sinanuyan/WeatherStation/README.md

# WeatherStation
Opensource Weather Station with OpenWeather
