sinanuyan/WeatherStation/hardware/PCB/TemperatureSensor.kicad_pcb

## KiCad design hardware/PCB/TemperatureSensor.kicad_pcb (2021-02-13)

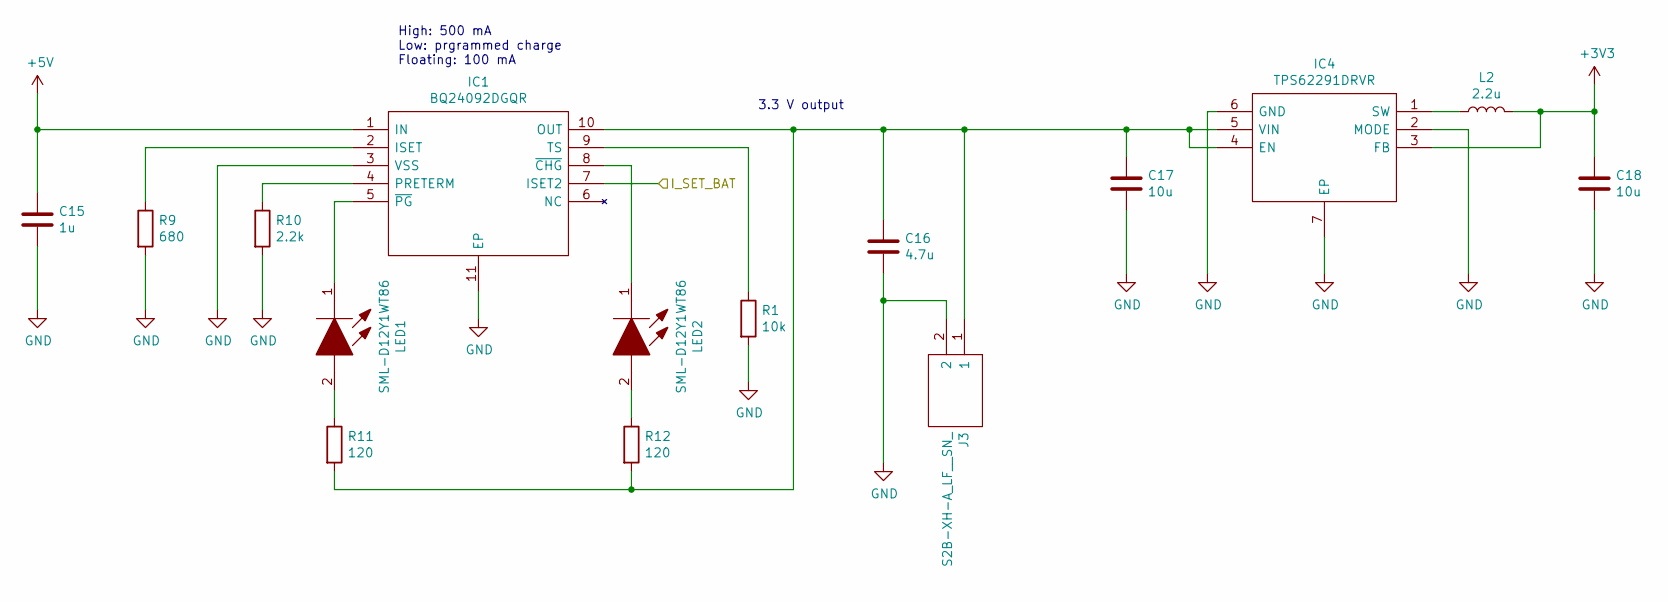
[picture p1: schematic PowerSupply.sch]

Parts:
C15: 1u; C_0603_1608Metric
C16: 4.7u; C_0603_1608Metric
C17, C18: 10u; C_0603_1608Metric
IC1: BQ24092DGQR; SOP50P490X110-11N; Mouser Part Number 595-BQ24092DGQR
IC4: TPS62291DRVR; SON65P200X200X80-7N; Mouser Part Number 595-TPS62291DRVR
J3: S2B-XH-A_LF__SN_; SHDRRA2W80P0X250_1X2_740X1150X610P; Manufacturer_Part_Number S2B-XH-A(LF)(SN)
L2: 2.2u; L_Coilcraft_LPS4018; Mouser Part Number 994-LPS4018-222MRB
LED1, LED2: SML-D12Y1WT86; LEDC1608X55N; Mouser Part Number 755-SML-D12Y1WT86
R1: 10k; R_0603_1608Metric
R9: 680; R_0603_1608Metric
R10: 2.2k; R_0603_1608Metric
R11, R12: 120; R_0603_1608Metric

Connections:
+5V: C15.1, IC1.1 (IN); also elsewhere on the board
/ESP32/BAT_PWR: IC1.7 (ISET2); also elsewhere on the board
GND: C15.2, C16.2, C17.2, C18.2, IC1.3 (VSS), IC1.11 (EP), IC4.2 (MODE), IC4.6 (GND), IC4.7 (EP), J3.2, R1.2, R9.2, R10.2; also elsewhere on the board
unnamed: C16.1, C17.1, IC1.10 (OUT), IC4.4 (EN), IC4.5 (VIN), J3.1, R11.2, R12.2
unnamed: IC1.2 (ISET), R9.1
unnamed: IC1.4 (PRETERM), R10.1
unnamed: IC1.5 (~PG), LED1.1
unnamed: IC1.8 (~CHG), LED2.1
unnamed: IC1.9 (TS), R1.1
unnamed: IC4.1 (SW), L2.1
unnamed: LED1.2, R11.1
unnamed: LED2.2, R12.1

Notes on the sheet:
3.3 V output
High: 500 mA Low: prgrammed charge Floating: 100 mA

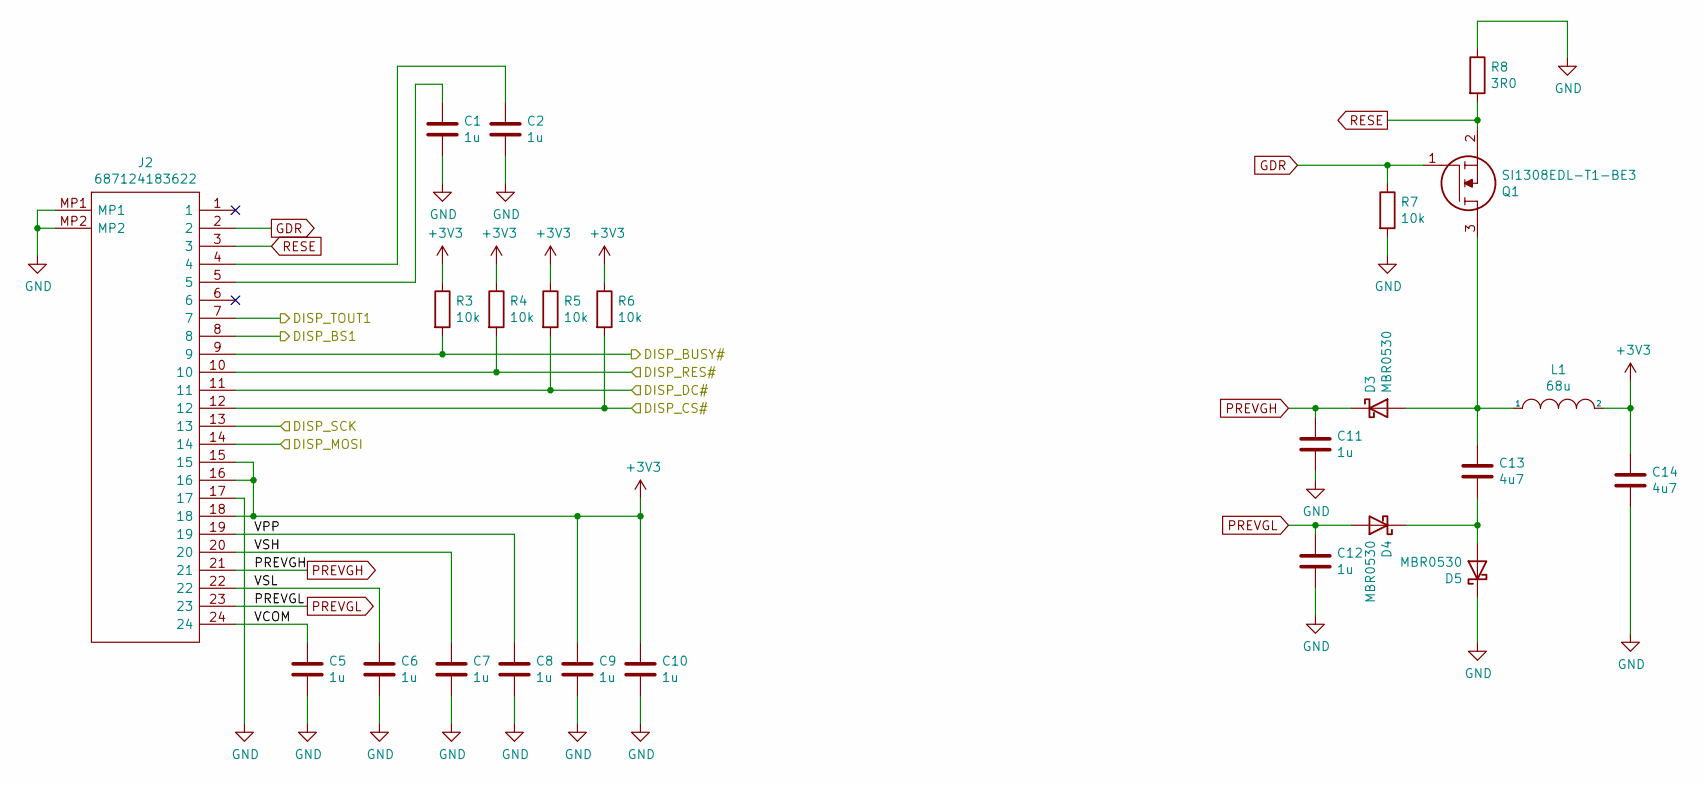
[picture p2: schematic Display.sch]

Parts:
C1, C2, C5, C6, C7, C8, C9, C10, C11, C12: 1u; C_0603_1608Metric
C13, C14: 4u7; C_0603_1608Metric
D3, D4, D5: MBR0530; D_SOD-123
J2: 687124183622; Mouser Part Number 710-687124183622
L1: 68u; L_0805_2012Metric
Q1: SI1308EDL-T1-BE3; SOT65P210X110-3N; Manufacturer_Part_Number SI1308EDL-T1-BE3
R3, R4, R5, R6, R7: 10k; R_0603_1608Metric
R8: 3R0; R_0603_1608Metric

Connections:
/Display/DISP_BS1: J2.8; also elsewhere on the board
/Display/DISP_MOSI: J2.14; also elsewhere on the board
/Display/DISP_TOUT1: J2.7; also elsewhere on the board
/Display/VCOM: C5.1, J2.24
/Display/VPP: C8.1, J2.19
/Display/VSH: C7.1, J2.20
/Display/VSL: C6.1, J2.22
/ESP32/DISP_BUSY: J2.9, R3.2; also elsewhere on the board
/ESP32/DISP_CLK: J2.13; also elsewhere on the board
/ESP32/DISP_CS: J2.12, R6.2; also elsewhere on the board
/ESP32/DISP_DC: J2.11, R5.2; also elsewhere on the board
/ESP32/DISP_RES: J2.10, R4.2; also elsewhere on the board
GDR: J2.2, Q1.1, R7.1
GND: C1.2, C2.2, C5.2, C6.2, C7.2, C8.2, C9.2, C10.2, C11.2, C12.2, C14.2, D5.1 (K), J2.17, J2.MP1, J2.MP2, R7.2, R8.1; also elsewhere on the board
unnamed: C1.1, J2.5
unnamed: C2.1, J2.4
unnamed: C13.1, D3.2 (A), L1.1, Q1.3
unnamed: C13.2, D4.1 (K), D5.2 (A)
PREVGH: C11.1, D3.1 (K), J2.21
PREVGL: C12.1, D4.2 (A), J2.23
RESE: J2.3, Q1.2, R8.2

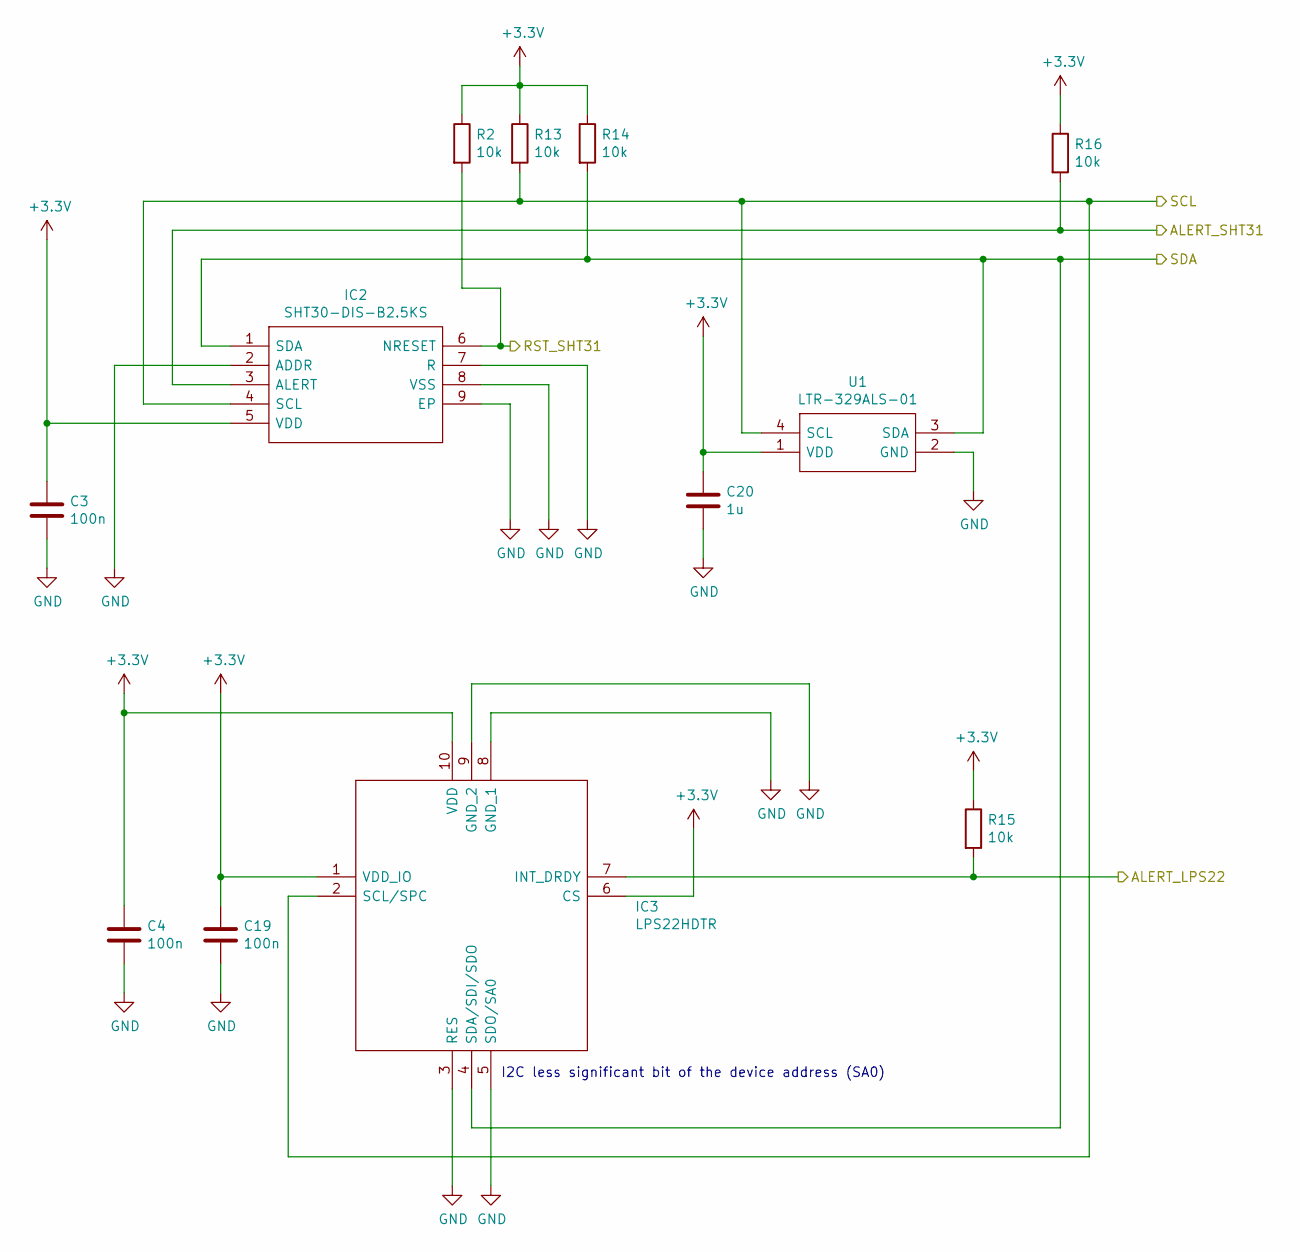
[picture p3: schematic Sensor.sch]

Parts:
C3, C4, C19: 100n; C_0603_1608Metric
C20: 1u; C_0603_1608Metric
IC2: SHT30-DIS-B2.5KS; SHT30DISB25KS; Manufacturer_Part_Number SHT30-DIS-B2.5KS
IC3: LPS22HDTR; Mouser Part Number 511-LPS22HDTR
R2, R13, R14, R15, R16: 10k; R_0603_1608Metric
U1: LTR-329ALS-01; LTR329ALS01; Mouser Part Number 859-LTR-329ALS-01

Connections:
/ESP32/I2C_SCL: IC2.4 (SCL), IC3.2 (SCL/SPC), R13.2, U1.4 (SCL); also elsewhere on the board
/ESP32/I2C_SDA: IC2.1 (SDA), IC3.4 (SDA/SDI/SDO), R14.2, U1.3 (SDA); also elsewhere on the board
/Sensor/ALERT_LPS22: IC3.7 (INT_DRDY), R15.2
/Sensor/ALERT_SHT31: IC2.3 (ALERT), R16.2
/Sensor/RST_SHT31: IC2.6 (NRESET), R2.2; also elsewhere on the board
GND: C3.2, C4.2, C19.2, C20.2, IC2.2 (ADDR), IC2.7 (R), IC2.8 (VSS), IC2.9 (EP), IC3.3 (RES), IC3.5 (SDO/SA0), IC3.8 (GND_1), IC3.9 (GND_2), U1.2 (GND); also elsewhere on the board

Notes on the sheet:
I2C less significant bit of the device address (SA0)

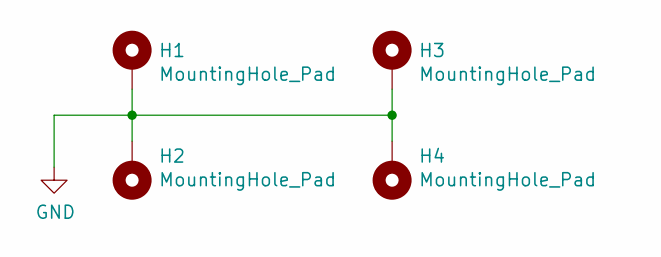
[picture p4: schematic MECH.sch]

Parts:
H1, H2, H3, H4: MountingHole_Pad; MountingHole_2.5mm

Connections:
GND: H1.1, H2.1, H3.1, H4.1; also elsewhere on the board

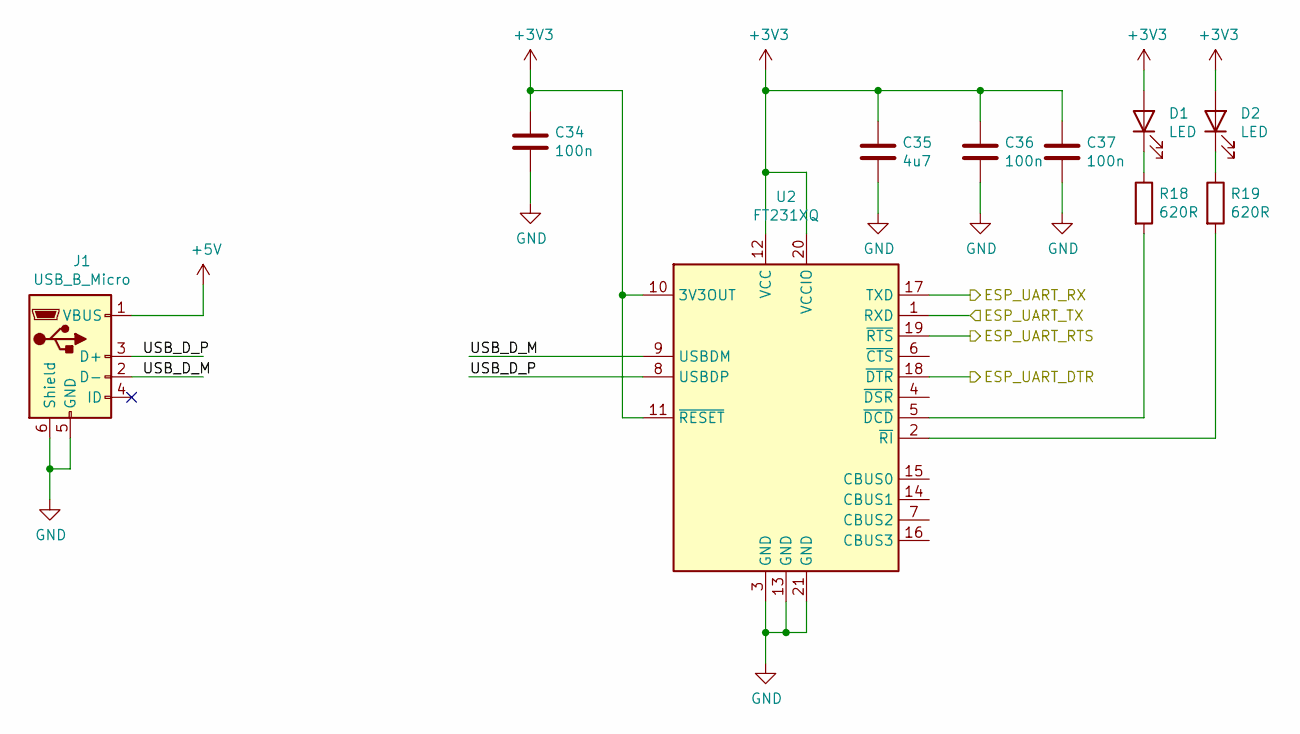
[picture p5: schematic USB_FTDI.sch]

Parts:
C34, C36, C37: 100n; C_0603_1608Metric
C35: 4u7; C_0603_1608Metric
D1, D2: LED; LED_0603_1608Metric
J1: USB_B_Micro; USB_Micro-B_Amphenol_10118194_Horizontal
R18, R19: 620R; R_0603_1608Metric
U2: FT231XQ; QFN-20-1EP_4x4mm_P0.5mm_EP2.5x2.5mm

Connections:
+5V: J1.1 (VBUS); also elsewhere on the board
/USB FTDI/ESP_UART_DTR: U2.18 (~DTR); also elsewhere on the board
/USB FTDI/ESP_UART_RTS: U2.19 (~RTS); also elsewhere on the board
/USB FTDI/ESP_UART_RX: U2.17 (TXD); also elsewhere on the board
/USB FTDI/ESP_UART_TX: U2.1 (RXD); also elsewhere on the board
/USB FTDI/USB_D_M: J1.2 (D-), U2.9 (USBDM)
/USB FTDI/USB_D_P: J1.3 (D+), U2.8 (USBDP)
GND: C34.2, C35.2, C36.2, C37.2, J1.5 (GND), J1.6 (Shield), U2.3 (GND), U2.13 (GND), U2.21 (GND); also elsewhere on the board
unnamed: D1.1 (K), R18.1
unnamed: D2.1 (K), R19.1
unnamed: R18.2, U2.5 (~DCD)
unnamed: R19.2, U2.2 (~RI)

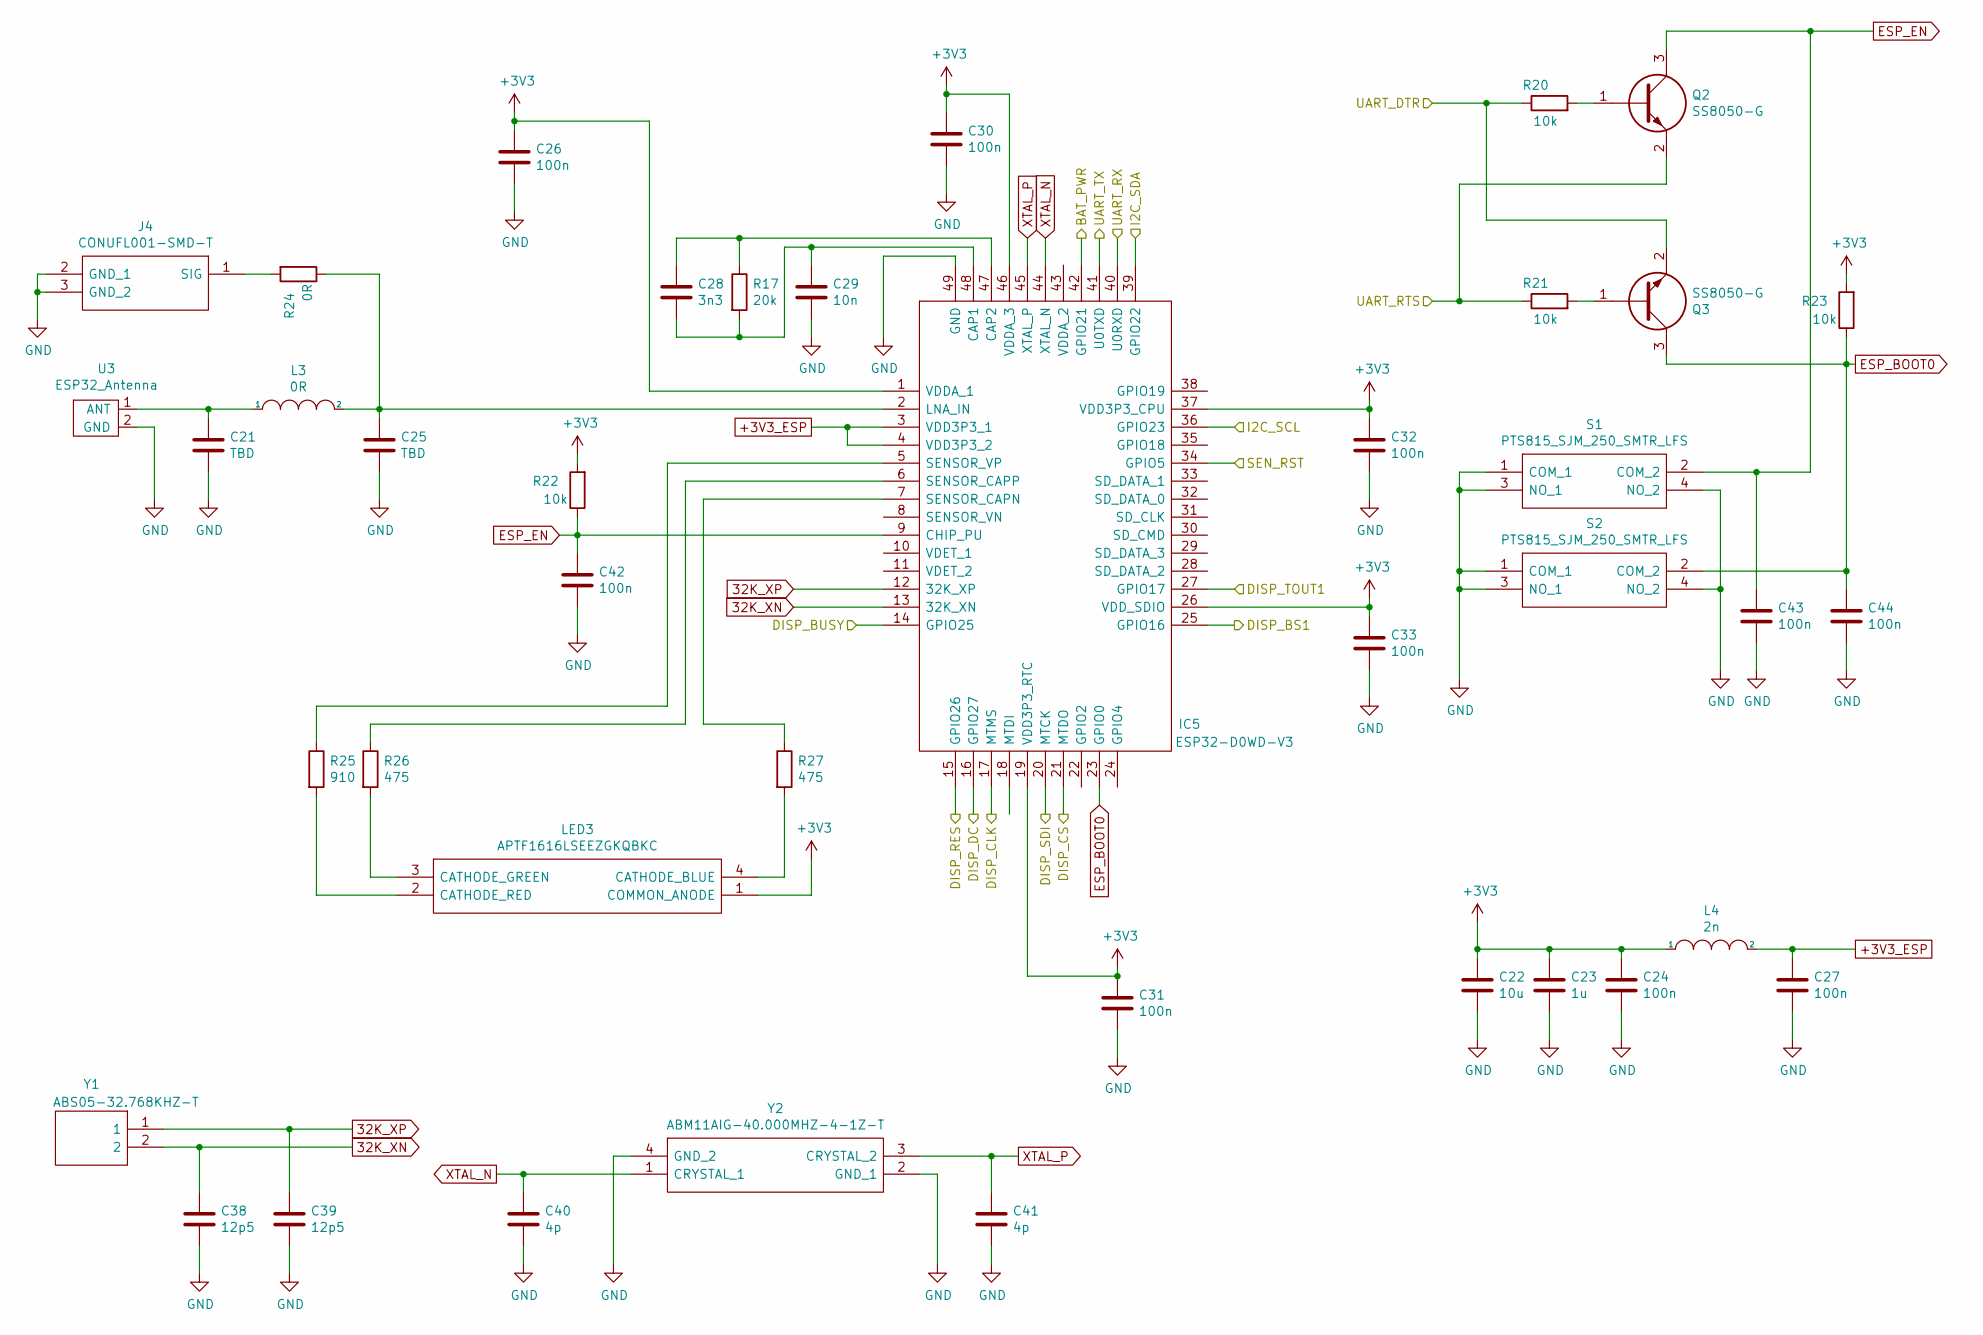
[picture p6: schematic ESP32.sch]

Parts:
C21, C25: TBD; C_0603_1608Metric
C22: 10u; C_0603_1608Metric
C23: 1u; C_0603_1608Metric
C24, C26, C27, C30, C31, C32, C33, C42, C43, C44: 100n; C_0603_1608Metric
C28: 3n3; C_0603_1608Metric
C29: 10n; C_0603_1608Metric
C38, C39: 12p5; C_0603_1608Metric
C40, C41: 4p; C_0603_1608Metric
IC5: ESP32-D0WD-V3; QFN35P500X500X90-49N-D; Mouser Part Number 356-ESP32-D0WD-V3
J4: CONUFL001-SMD-T; CONUFL001-SMD; Mouser Part Number 712-CONUFL001-SMD-T
L3: 0R; L_0603_1608Metric
L4: 2n; L_0603_1608Metric
LED3: APTF1616LSEEZGKQBKC; APTF1616SEEZGQBDC; Mouser Part Number 604-APTF1616LSEEZGKQ
Q2, Q3: SS8050-G; SOT95P240X115-3N; Mouser Part Number 750-SS8050-G
R17: 20k; R_0603_1608Metric
R20, R21, R22, R23: 10k; R_0603_1608Metric
R24: 0R; R_0603_1608Metric
R25: 910; R_0603_1608Metric
R26, R27: 475; R_0603_1608Metric
S1, S2: PTS815_SJM_250_SMTR_LFS; PTS815SJM250SMTRLFS; Mouser Part Number 611-PTS815SJM250SMTR
U3: ESP32_Antenna; Texas_SWRA117D_2.4GHz_Right
Y1: ABS05-32.768KHZ-T; ABS05; Mouser Part Number 815-ABS05-32.768K-T
Y2: ABM11AIG-40.000MHZ-4-1Z-T; ABM11AIG40000MHZ41ZT; Mouser Part Number 815-M11AIG-40-4-1ZT

Connections:
32K_XN: C38.1, IC5.13 (32K_XN), Y1.2
32K_XP: C39.1, IC5.12 (32K_XP), Y1.1
+3V3_ESP: C27.1, IC5.3 (VDD3P3_1), IC5.4 (VDD3P3_2), L4.2
/Display/DISP_BS1: IC5.25 (GPIO16); also elsewhere on the board
/Display/DISP_MOSI: IC5.20 (MTCK); also elsewhere on the board
/Display/DISP_TOUT1: IC5.27 (GPIO17); also elsewhere on the board
/ESP32/BAT_PWR: IC5.42 (GPIO21); also elsewhere on the board
/ESP32/DISP_BUSY: IC5.14 (GPIO25); also elsewhere on the board
/ESP32/DISP_CLK: IC5.17 (MTMS); also elsewhere on the board
/ESP32/DISP_CS: IC5.21 (MTDO); also elsewhere on the board
/ESP32/DISP_DC: IC5.16 (GPIO27); also elsewhere on the board
/ESP32/DISP_RES: IC5.15 (GPIO26); also elsewhere on the board
/ESP32/I2C_SCL: IC5.36 (GPIO23); also elsewhere on the board
/ESP32/I2C_SDA: IC5.39 (GPIO22); also elsewhere on the board
/Sensor/RST_SHT31: IC5.34 (GPIO5); also elsewhere on the board
/USB FTDI/ESP_UART_DTR: Q3.2, R20.1; also elsewhere on the board
/USB FTDI/ESP_UART_RTS: Q2.2, R21.1; also elsewhere on the board
/USB FTDI/ESP_UART_RX: IC5.40 (U0RXD); also elsewhere on the board
/USB FTDI/ESP_UART_TX: IC5.41 (U0TXD); also elsewhere on the board
ESP_BOOT0: C44.1, IC5.23 (GPIO0), Q3.3, R23.1, S2.2 (COM_2)
ESP_EN: C42.1, C43.1, IC5.9 (CHIP_PU), Q2.3, R22.1, S1.2 (COM_2)
GND: C21.2, C22.2, C23.2, C24.2, C25.2, C26.2, C27.2, C29.2, C30.2, C31.2, C32.2, C33.2, C38.2, C39.2, C40.2, C41.2, C42.2, C43.2, C44.2, IC5.49 (GND), J4.2 (GND_1), J4.3 (GND_2), S1.1 (COM_1), S1.3 (NO_1), S1.4 (NO_2), S2.1 (COM_1), S2.3 (NO_1), S2.4 (NO_2), U3.2 (GND), Y2.2 (GND_1), Y2.4 (GND_2); also elsewhere on the board
unnamed: C21.1, L3.1, U3.1 (ANT)
unnamed: C25.1, IC5.2 (LNA_IN), L3.2, R24.1
unnamed: C28.1, IC5.47 (CAP2), R17.1
unnamed: C28.2, C29.1, IC5.48 (CAP1), R17.2
unnamed: IC5.5 (SENSOR_VP), R25.1
unnamed: IC5.6 (SENSOR_CAPP), R26.1
unnamed: IC5.7 (SENSOR_CAPN), R27.1
unnamed: J4.1 (SIG), R24.2
unnamed: LED3.2 (CATHODE_RED), R25.2
unnamed: LED3.3 (CATHODE_GREEN), R26.2
unnamed: LED3.4 (CATHODE_BLUE), R27.2
unnamed: Q2.1, R20.2
unnamed: Q3.1, R21.2
XTAL_N: C40.1, IC5.44 (XTAL_N), Y2.1 (CRYSTAL_1)
XTAL_P: C41.1, IC5.45 (XTAL_P), Y2.3 (CRYSTAL_2)

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
Board: 2 copper layers, 106 parts (0 on the bottom side), 68 nets, no tracks yet.
