sinanuyan/WeatherStation/(commit log)

2020-11-19 initial KiCAD commit
    [TemperatureSensor.kicad_pcb, TemperatureSensor.sch]
2020-11-22 Add temperature and ambient light sensor to library
2020-11-22 Add new sensors to board
    [TemperatureSensor.kicad_pcb, TemperatureSensor.sch]
2020-11-22 add usb and ftdi circuit
    [TemperatureSensor.kicad_pcb, TemperatureSensor.sch]
2020-11-23 started display circuit
    [Display.sch, TemperatureSensor.kicad_pcb, TemperatureSensor.sch]
2020-11-25 Add 4 mounting holes with via pads
    [TemperatureSensor.sch]
2020-11-25 Add BQ24092DGQR for LiPo charging
    [Display.sch, PowerSupply.sch, TemperatureSensor.sch]
2020-11-25 Added battery connector
    [PowerSupply.sch]
2020-11-25 edited display circuit
    [Display.sch]
2020-11-26 Add TPS62290DRV to PowerSupply
    [PowerSupply.sch, TemperatureSensor.sch]
2020-11-28 complete display circuit
    [Display.sch, PowerSupply.sch, TemperatureSensor.sch]
2020-11-28 change power out to 3V3
    [PowerSupply.sch]
2020-11-28 add ESP32 and Sensor Sheet
    [Display.sch, ESP32.sch, PowerSupply.sch, Sensor.sch, TemperatureSensor.sch]
2020-11-28 started ESP32 Schematic
    [ESP32.sch]
2020-11-29 Complete Sensor schematic
    [Sensor.sch, TemperatureSensor.sch]
2020-11-29 Add LPS22HD pressure sensor
    [Sensor.sch]
2020-12-13 add 10k pull up
    [Display.sch, PowerSupply.sch, Sensor.sch, TemperatureSensor.sch]
2020-12-27 add mechannical and usb ftdi sheet
    [Display.sch, ESP32.sch, MECH.sch, PowerSupply.sch, Sensor.sch, TemperatureSensor.sch, USB_FTDI.sch]
2020-12-27 corretcted usb plus minus connection
    [USB_FTDI.sch]
2020-12-27 add 32khz crystal for rtc
    [ESP32.sch, TemperatureSensor.sch, USB_FTDI.sch]
2020-12-27 add ESP32 antenna
    [ESP32.sch, PowerSupply.sch, Sensor.sch]
2020-12-27 add inductor footprint LPS4018
    [PowerSupply.sch]
2020-12-27 corrected power supply schematic
    [PowerSupply.sch, TemperatureSensor.sch]
2020-12-27 add 40 MHz crystal
    [ESP32.sch, PowerSupply.sch, TemperatureSensor.sch]
2020-12-27 changed FTDI chip to full handshake chip
    [TemperatureSensor.sch, USB_FTDI.sch]
2020-12-27 changed to dtr
    [USB_FTDI.sch]
2020-12-27 add ESP32 bootloader circuit
    [ESP32.sch, TemperatureSensor.sch]
2020-12-27 add enable and boot0 buttons
    [ESP32.sch, TemperatureSensor.sch, USB_FTDI.sch]
2020-12-27 complete bootloader circuit
    [ESP32.sch]
2020-12-27 updated pcb
    [TemperatureSensor.kicad_pcb]
2020-12-29 Add ABS05-32.768KHZ-T symbol and footprint
2020-12-29 Use added ABS05 symbol and footprint form project library
    [ESP32.sch]
2020-12-29 Connect ESP32 pins
    [ESP32.sch, TemperatureSensor.sch]
2020-12-29 Connect Display
    [ESP32.sch, TemperatureSensor.sch]
2020-12-30 correctrts, dtr connection, change spi connections, complete display connection
    [ESP32.sch, TemperatureSensor.sch, USB_FTDI.sch]
2021-01-17 Added debug led fixed #1
    [ESP32.sch]
2021-01-17 add ufl connector
    [ESP32.sch]
2021-01-19 Order parts in groups
    [ESP32.sch, MECH.sch, TemperatureSensor.kicad_pcb]
2021-01-19 Sort components
    [TemperatureSensor.kicad_pcb]
2021-02-13 component placement done
    [Display.sch, TemperatureSensor.kicad_pcb, USB_FTDI.sch]
